St0nefish/bed-mat-openscad/(commit log)

2026-04-15 Initial commit: parametric bed mat organizer generator
    OpenSCAD generator for custom truck bed mat attachments compatible with
    TMat and similar X-pattern snap-in systems. Supports post, straight wall,
    corner, T-shape, and hole plug parts with configurable sizing, fit
    adjustment, friction ribs, and locking bumps.
    [bed_mat_interface.scad]
2026-04-16 rebase fit defaults from test print results
    Bake -0.25mm base offset into profile so fit_clearance=0 is the tested
    ideal fit. Add material-based shrinkage compensation, lock bump
    protrusion control, and generate.sh CLI wrapper.
    New defaults: ASA material, lock bumps on (r=2.0, p=0.4), ribs off.
    [bed_mat_interface.scad]
2026-04-16 fix skill discovery, set default height to 64mm
    Move skill from flat file to directory format (SKILL.md) so Claude Code
    discovers it. Add defaults documentation so agent doesn't pass redundant
    flags. Set default height to 64mm (~2.5", matching OEM pieces).
    [bed_mat_interface.scad]
2026-04-17 add .env config for generate.sh defaults
    Source a non-tracked .env next to the script before arg parsing so users
    can pin project-local defaults (OUTPUT_DIR, MATERIAL, LOCK_BUMPS, ...)
    without editing the script. CLI flags still override.
    Also: --no-lock / --no-joint flags for override symmetry, boolean vars
    pass through any value (so .env can disable features), _nolock filename
    tag when locks are explicitly off, and OPENSCAD env var to point at a
    specific binary.
2026-09-29 fix plug notch breach and off-grid dense leg interfaces
    - Plug finger notch was cut at the cap/interface seam and punched
    through the cap into the hollow arms (genus 2). Move it to the
    visible top face and cap its depth below the cap thickness.
    - In dense spacing, corner/tee legs placed interfaces every 25.4mm,
    between recesses. Only place leg interfaces on grid positions, and
    warn when a corner/tee ends up with no interfaces at all.
    [bed_mat_interface.scad]
2026-09-29 generate.sh: fix ribs toggle, filenames, genus parsing, stale help
    - Add --ribs; ADD_RIBS=true in .env was silently ignored
    - Auto filename used 40mm fallback height (default is 64); omit
    height for plugs; only tag _ribs when ribs are actually enabled
    - Genus regex failed on current OpenSCAD's padded output
    - Surface OpenSCAD warnings on successful renders
    - Help text: update defaults (ASA, 64mm, lock 2.0/0.4) and examples
2026-09-29 docs: document generate.sh/.env, current defaults, and sizing rules
    - README: CLI usage and .env config, defaults table, correct straight
    wall sizing (body centered, extension split both ends), corner/tee
    leg interface placement
    - CLAUDE.md: fix skill path, list .env.example
    - Skill: --no-lock/--ribs flags, sizing notes
